grizzie17/Rollator-Vision/README.md

# Rollator-Vision #

Ultrasonic sensors for a Rollator (Walker).  The goal is to provide assistance for visually impared individuals that must use a walker and thus can not use a blind tapper cane.

The first test unit will be married to a `Medline Empower Rollator Walker`.

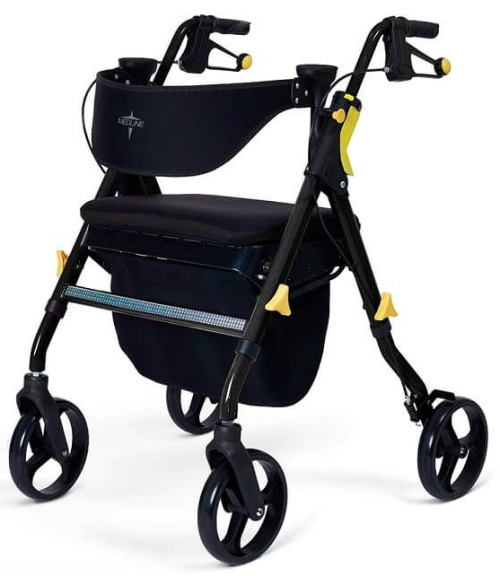
[picture p1: images/medline_empower_rollator_black.jpg]
Medline Empower Rollator Walker
  
Medline Empower Rollator Walker

This first unit will be mounted on the front horizontal bar in front of the storage bag.

| description | dimension |
| --- | --- |
| Overall Width | 26.5 in |
| Cross Bar Width | ~17 in |
| ~ Cross Bar Angle | 60 deg |

-----

## Requirements ##

* Warn user when nearing obstacles.
  * User adjustable distance range.
  * Vibrate handles
  * three different vibration patterns:
    * front, side, both
* Battery powered without the need for on/off switches
  * Battery must last for at least two weeks but preferred four weeks

-----

## Overall Circuit ##

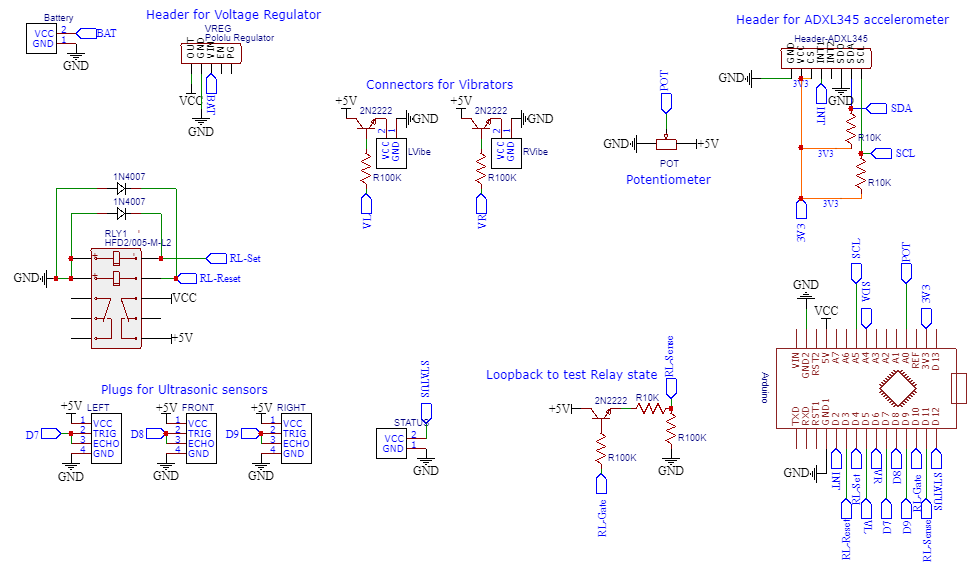
[picture p2: images/rollator-circuit-v6.png]
Circuit


The core of the system is an `Arduino nano` microprocessor.  No devices (sensors) are powered directly from the microprocessor with the exception of the ADXL345 accelerometer (which is powered from the microprocessor's 3.3V pin).

One of the main requirements is that there be no need for a user selectable power switch.  To accomplish this we must be very judicious with the power. We will powerdown or force devices to enter a sleep-mode.  We use an accelerometer to recognize motion (or lack thereof) and wake up or put the microprocessor to sleep as needed.  The microprocessor and the accelerometer are the only items that have continuous power (but both can be put to sleep), all other devices are powered via a 5V relay.  When the microprocessor sleeps the relay disconnects the power.

The microprocessor polls three ultrasonic sensors at an effective rate of 12hz (that is 4hz for each sensor multiplied by the number of sensors).  The three ultrasonic sensors are arranged with one forward facing sensor, and two side facing sensors (left and right).

To provide user feedback, there are two vibrators that will be placed, one in each handle bar.  No vibration indicates that no obstacles are near.  Vibration from both handles indicates that an obstacle is ahead of the Rollator.  An individual handle vibrating indicates obstacles on the corresponding side.

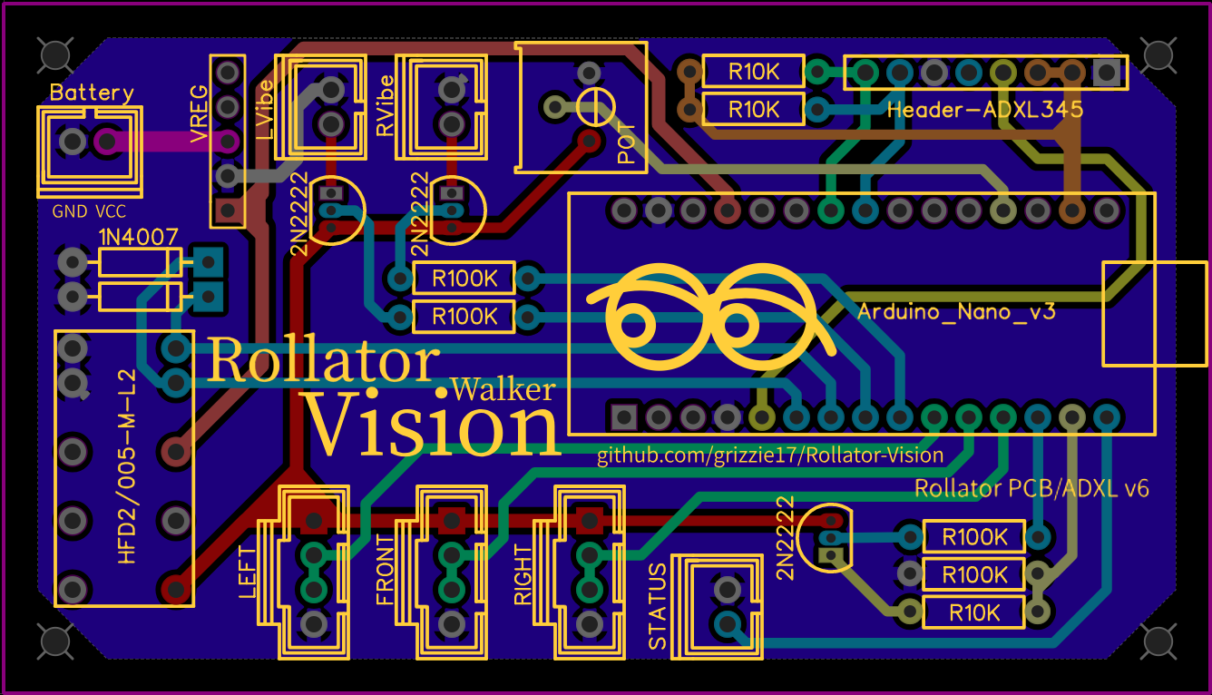
[picture p3: images/PCB-v6.png]
Printed Circuit Board
  
Printed Circuit Board Diagram

-----

## Arduino nano ##

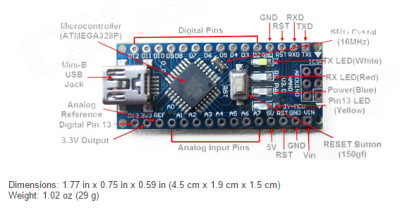
[picture p4: images/arduino-nano-rev3.png]
Arduino Nano V3


The `Arduino Nano V3` microprocessor is the heart of our Rollator-Vision project.

To reduce power, we unsolder the `Power` and `Pin13` LEDs. The other LEDs should be okay since in the non-debug version we don't write anything to the Serial Console (TX,RX);

Please see the tables in the sections below for connection details to the Arduino.

-----

## Battery Pack ##

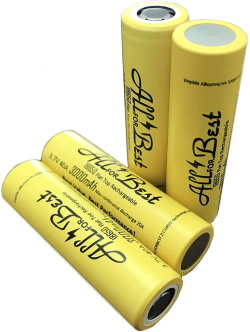
[picture p5: images/18650_3000mAh.jpg]
18650 Batteries


The `Battery Pack` will be made from 18650 batteries.  Each pack is configured as 2S4P (2 Series and 4 Parallel).  Each battery cell is rated at 3000 mAh, providing an overall nominal rating, 7.4V 12000 mAh. The actual voltage range is from 8.30V to 5.80V.  We are also experimenting with a 2S2P battery pack with half the milliamp-hour rating.

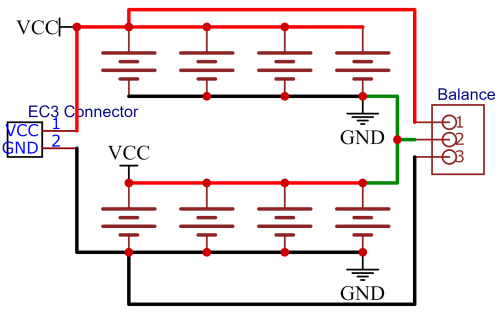
[picture p6: images/battery-pack-circuit.png]
battery-pack-circuit


The packs will use an EC3 connector (frequently used on R/C models), and a 3 wire balance connector which will allow the pack to be charged using a standard R/C balancing battery charger (that includes a Li-Ion setting).

-----

## Voltage Regulator ##

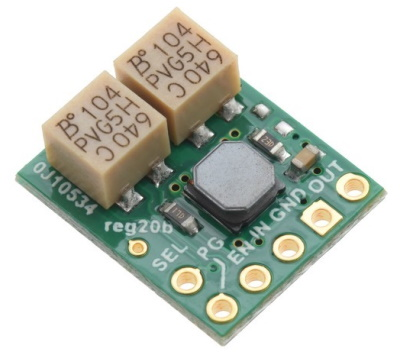
[picture p7: images/pololu-1.jpg]
Pololu Regulator


Pololu 2.5-16V Fine-Adjust Step-Up/Step-Down Voltage Regulator w/ Adjustable Low-Voltage Cutoff S9V11MACMA

[Spec. Sheet](https://www.pololu.com/product/2868)

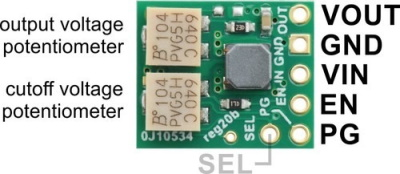
[picture p8: images/pololu-3.jpg]
Regulator Pins


| pin  | description |
| ---- | --- |
| VOUT | Output voltage; determined by the trimmer potentiometer |
| GND  | Ground |
| VIN  | Input voltage; should be between 3V-16V |
| EN | Enable; used for setting cutoff voltage |
| PG | Power Good |

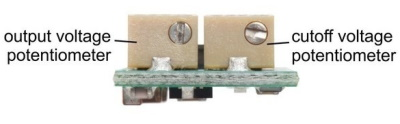
[picture p9: images/pololu-2.jpg]
Setting Output and Cutoff


### Setting the output voltage ###

The output voltage of the regulator is controlled with a 12-turn precision potentiometer. Turning the potentiometer clockwise increases the output voltage, and it can be measured using a multimeter.

> Connect your powersupply (fully charged battery) to the VIN and GND. Connect your multimeter to the GND and VOUT.  Adjust the potentiometer so the VOUT is 5.15V.

### Setting the cutoff voltage ###

The low VIN cutoff voltage of the regulator is controlled by adjusting the voltage at the EN pin with a 12-turn precision potentiometer. When the voltage on the EN pin falls below 0.7V the regulator is put in a low-power sleep state and when the voltage on EN rises back above 0.8V the regulator is turned back on. Turning the potentiometer clockwise increases the low-voltage cutoff. The cutoff voltage can be set by measuring the voltage on the VIN and EN pins and using the potentiometer to adjust the voltage on EN according to the following equation:

EN / 0.7V = VIN / VIN cutoff

EN = VIN * 0.7V / VIN cutoff

For example, if you connect VIN to a battery that currently measures 3.7V and you want to set the cutoff voltage to 3.0V, the equation becomes:

EN / 0.7V = 3.7V / 3.0V

Solving for EN yields approximately 0.86V, so you should turn the potentiometer until you measure that voltage on the EN pin.

Note that the regulator’s low VIN cutoff behavior includes hysteresis: the regulator turns off when EN falls below 0.7V, but it does not turn back on until EN rises above 0.8V. Therefore, VIN must reach about 114% of the cutoff voltage before the regulator will re-enable its output (about 3.43V in this example).

### So for our purposes ###

> Connect your powersupply (battery) to the VIN and GND. Connect your multimeter to GND and EN pins to correctly measure and adjust the cutoff voltage.

LiPo VIN cutoff should be 7.0V and the fully charged battery pack should be 8.4V.

EN = 8.4V * 0.7V / 7.0V  
EN = 0.87

Li-Ion VIN cutoff should be 5.8V and the fully charged battery pack should be 8.3V.

EN = 8.3V * 0.7V / 6.4V  
EN = 0.908

-----

## ADXL345 Accelerometer ##

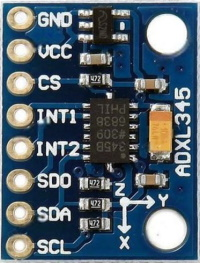
[picture p10: images/ADXL345-Accelerometer-Module.jpg]
ADXL345 Accelerometer


The `Accelerometer` is used for two purposes in our system:

* provide a wakeup/sleep identifier based on motion of the walker.
* recognize that the walker has been layed down on either its back or its side and put the walker to sleep regardless of other motion.

We use the I2C connections using SDA and SCL.

The following table identifies the connections for the
ADXL345 to an Arduino Nano

| ADXL345 | Arduino | Notes |
| --- | --- | --- |
| GND | GND | |
| VCC | 3.3V | |
| CS | 3.3V | |
| INT1 | D2 (INT0) Yellow | use Interrupts |
| INT2 | - | |
| SD0 | GND | |
| SDA | A4 (SDA) blue | 10k resistor to VCC |
| SCL | A5 (SCL) green | 10k resistor to VCC |
| | | |

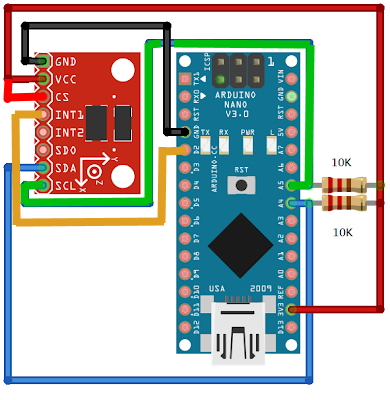
[picture p11: images/adxl345.png]
  
Connection Diagram

-----

## Relay ##

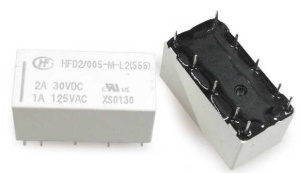
[picture p12: images/HFD2-005-M-L2-D.jpg]
Relay


The relay is used to power-up the ultrasonic sensors and other devices (with the exception of the ADXL345) for when they are needed. Otherwise they are powered-down.

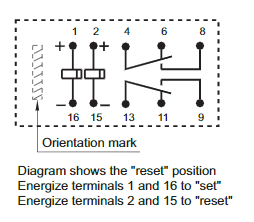
[picture p13: images/Relay-pins.png]
Relay-Pins


> Please note that the pins identified above are not sequential.  They are using position on a breadboard (e.g., pins 3,5,7,10,12,14) are non-existant. In our case, we will not be using pins 6, 9-13.

The relay being used has been changed to the HFD2/005-M-L2-D which is a double poll double throw relay.  The important part of this relay is that it does not require power to maintain set/reset condition.  There are two pins that control the unit; one for `set` (on) and the other for `reset` (off).  Setting the appropriate pin to +5V for 5 milliseconds will change the relay setting.

| Relay | Arduino | Circuit |
| ----- | --- | --- |
| 1 | D3 | (reset) |
| 2 | D4 | (set) |
| 4 | | VCC (from Reg.) |
| 8 | | OUT +5V |
| 16,15 | GND | GND |

-----

## HC-SR04 Ultrasonic Sensors ##

There are three HC-SR04 sensors.  One facing forward,
one facing left, one facing right.

| HC-SR04 | Arduino | Notes |
| --- | --- | --- |
| VCC | - | Relay VOUT |
| Trigger | D7,8,9  | Echo connected |
| Echo | Trigger | |
| GND | GND | |

Using the `YogiSonic` library allows us to connect the `trigger` and `echo` pins so we save pins on the Arduino.

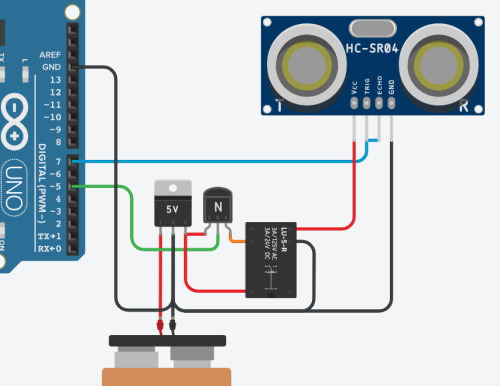
[picture p14: images/HC-SR04.png]


> This diagram is not completely accurate but does represent an external battery being sent through a voltage regulator and then a [relay](#relay).

-----

## Vibrator ##

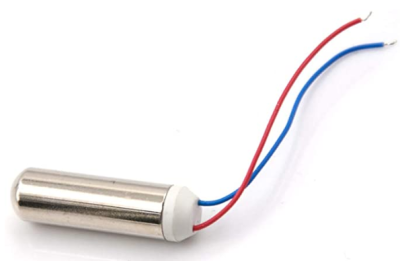
[picture p15: images/vibrator.png]
Vibrator


* Size: 7 x 25 mm
* Voltage: 1.5-3V

Used in Rollator/Walker hand-grips to notify user of obstacles.

We will use RCA jacks to connect the vibrator to the sensor housing (box).

-----

## Parts List ##

| ID | Name | Qty |
| --- | --- | --- |
| Nano | Arduino nano V3 | 1 |
| HC-SR04 | Ultrasonic sensor | 3 |
| ADXL345 | Accelerometer | 1 |
| HFD2-005-M-L2-D | Latching Relay | 1 |
| S9V11MACMA | Pololu 2.5-16V Regulator | 1 |
| X0023QDG3D | Vibrator | 2 |
| LED | Status LED | 1 |
| 7.4V 12,000mAh  | 18650 (8) Battery Pack | 2+  |
| | | |
| 100K | Resistor | 2 |
| 10K | Resistor | 2 |
| 660 | Resistor | 2 |
| 2N2222 | Transistor | 3 |
| 1N4007 | Diode | 2 |

## Connectors ##

| Name | Usage | Qty |
| --- | --- | --- |
| 2pin Header  | Battery, Left/Right vibe, LED | 4 |
| 5pin Header  | Voltage regulator | 1 |
| 4pin Header  | Left/Front/Right Ultrasonic | 3 |
| 8pin Header  | ADXL345 | 1 |
| 15pin Header | Arduino nano | 2 |
| | | |
| EC3 Female | PCB to battery | 1 |
| EC3 Male | battery pack | 2 |
| 3pin balance | battery pack | 2 |
| | | |
| RCA Female | connector to PCB | 2 |
| RCA Male | lead to vibrator | 2 |

## Wiring Harnesses ##

### Battery Pack (2) ###

Two wiring harnesses per battery pack:

* EC3 Female connector, 16awg (red and black) wire (about 5"), soldered directly to pack.

* 3pin balance lead, soldered directly to three connections.

### Battery Connector ###

* EC3 Male connector, 16awg (red and black) wire, 2pin male Dupont connector

### Vibrator (2) ###

Two wiring harnesses:

* 2pin male Dupont connector, 22awg wire, RCA Female connector.  RCA Female connectors will be mounted in top of the sensor box (one left and one right).

* RCA Male connector with attached wiring directly soldered to the vibrators (one left and one right).

### Ultrasonic Sensors (3) ###

* 4pin male Dupont connector, 4-wire ribbon cable, 4pin female Dupont connector

-----

# Assembly #

* Solder potentiometer
* Solder relay
* Solder in resistors
* Solder headers for:
  * battery
  * voltage regulator
  * Arduino nano
  * left/right vibrators
  * Ultrasonic sensors
  * LED
  * accelerometer
* Solder two NPN BJTs (2N2222)

* Create wiring harnesses: (provide some slack but not too much). All wiring harnesses will use ribbon cables with Dupont connectors.
  * battery - 2 wire - with EC3 connector on the battery side
  * left/right vibrators - 2 wire - male connectors to female RCA jacks - vibrator to male RCA jacks
  * LED - 2 wire
  * left/front/right ultrasonic sensors - four wire - male on one side and female on the other
  * ADXL345? - 8 wire

-----

# Power #

This section contains measured information for the power usage and batteries.

| mA | Notes |
| ----: | --- |
| 120.2 | Batteries to Buck (Active) |
|  19.2 | Batteries to Buck (Sleep)  |
| 3.6 | Buck to Main |
|  15.6 | Buck load |
| | |
|  87.0 | Battery to Pololu (Active) |
| 2.5 | Battery to Pololu (Sleep)  |
| 3.6 | Pololu to Main ????? |

Question: Why is the "Pololu to Main" more than the "Battery to Pololu"?

## Endurance Test w/ LiPo Pack ##

LiPo battery 2S 7.4V (nominal) 5200 mAh 35C

| mA |  Day | Date |
| ---- | ---: | ---- |
| 8.39 | 1 | 7/28 |
| 8.14 | 7 | 8/3  |
| | | |
| 8.09 | 8 | 8/4  |
| 7.97 | 12 | 8/8  |

At the finishing voltage and the discharge rate we would most likely get close to three weeks of usage on a single charge.

## Endurance Test w/ 18650 2S4P Battery Pack ##

Li-Ion battery pack 2S4P 7.4V (Nominal) 12000 mAh

| mA |  Day | Date |
| ---- | ---: | ---- |
| 8.30 | 1 | 8/8  |
| 8.18 | 7 | 8/14 |
| | | |
| 8.16 | 8 | 8/15 |
| 8.13 | 14 | 8/21 |
| | | |
| 8.13 | 15 | 8/22 |
| 8.04 | 21 | 8/28 |
| | | |
| 8.03 | 22 | 8/29 |
| ?.?? | 23 | 8/30 |

Our goal with the Li-Ion pack is to get around four weeks of usage on a single charge.  At the current discharge rate we would most likely get five or more weeks of usage on a single charge.

## Endurance Test w/ 18650 2S2P Battery Pack ##

Li-Ion battery pack 2S2P 7.4V (Nominal) 6000 mAh.

The desire with the 2S2P is to be lighter and the housing can be made smaller for standard walkers.

| mA |  Day | Date |
| ---- | ---: | ---- |
| 8.26 | 0 | 9/11 |
| 8.24 | 1 | 9/11 |
| 8.21 | 2 | 9/12 |
| 8.19 | 3 | 9/13 |
| 8.17 | 4 | 9/14 |
| 8.16 | 5 | 9/15 |
| 8.15 | 6 | 9/16 |
| 8.13 | 7 | 9/17 |
| | | |
| 8.?? | 8 | 9/18 |
| 8.10 | 9 | 9/19 |
| ? | 10 | 9/20 |
| ? | 11 | 9/21 |
| ? | 12 | 9/22 |
| ? | 13 | 9/23 |
| ? | 14 | 9/24 |
| ? | | |
| 7.91 | 15 | 9/25 |
| 7.88 | 16 | 9/26 |
| 7.86 | 17 | 9/27 |
| 7.?? | 18 | 9/28 |
| 7.81 | 19 | 9/29 |
| 7.79 | 20 | 9/30 |
| 7.76 | 21 | 10/1 |
| | | |
| 7.?? | 22 | 10/2 |
| 7.64 | 23 | 10/3 |
| 7.46 | 24 | 10/4 |

Theroetically, this battery pack should achieve half of the 2S4P battery pack.  Three weeks might be possible.

## Battery Voltage Ranges ##

| Type | Nominal | Max  | Min |
| --- | --- | ---- | --- |
| 2S LiPo | 7.4 | 8.40 | 7.0 |
| 2S Li-Ion | 7.4 | 8.30 | 5.8 |
