grizzie17/Rollator-Vision/EasyEDA/Schematic_Rollator_2020-10-01_15-58-42.png

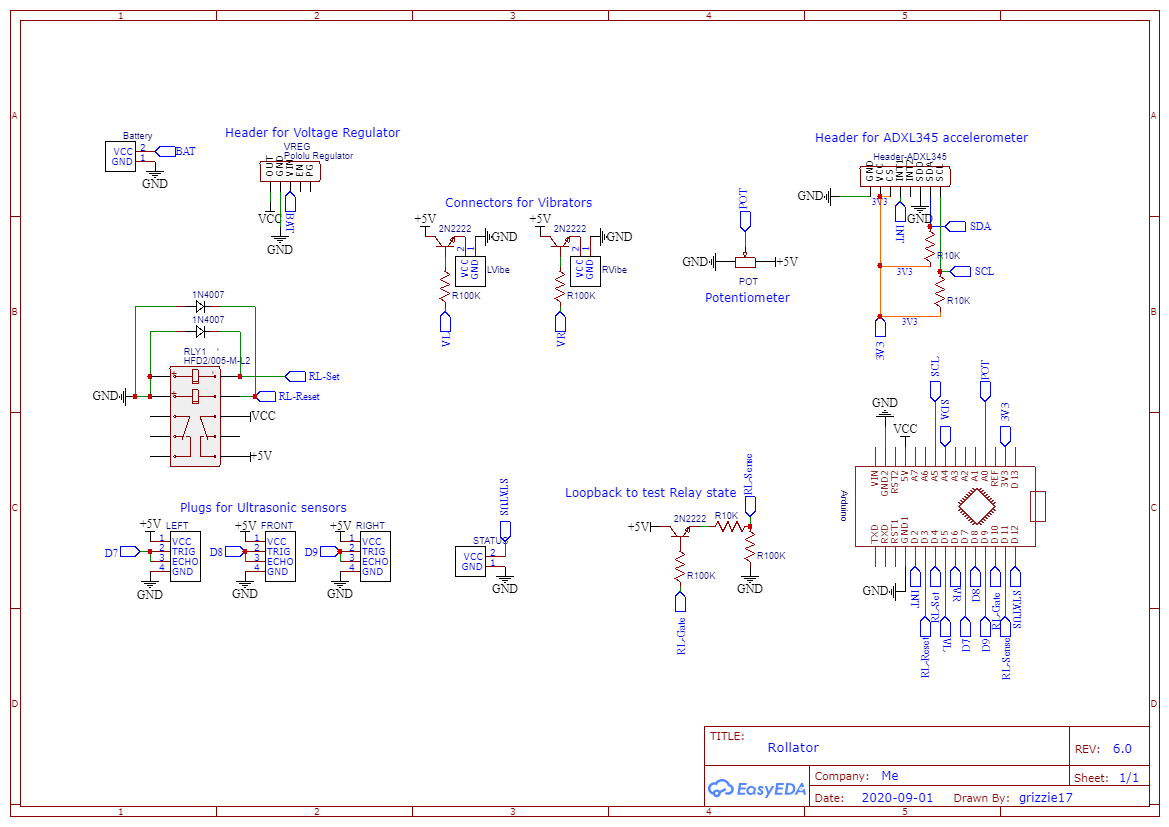
EasyEDA/Schematic_Rollator_2020-10-01_15-58-42.png
