grizzie17/Rollator-Vision/images/Arduino-nano.jpg

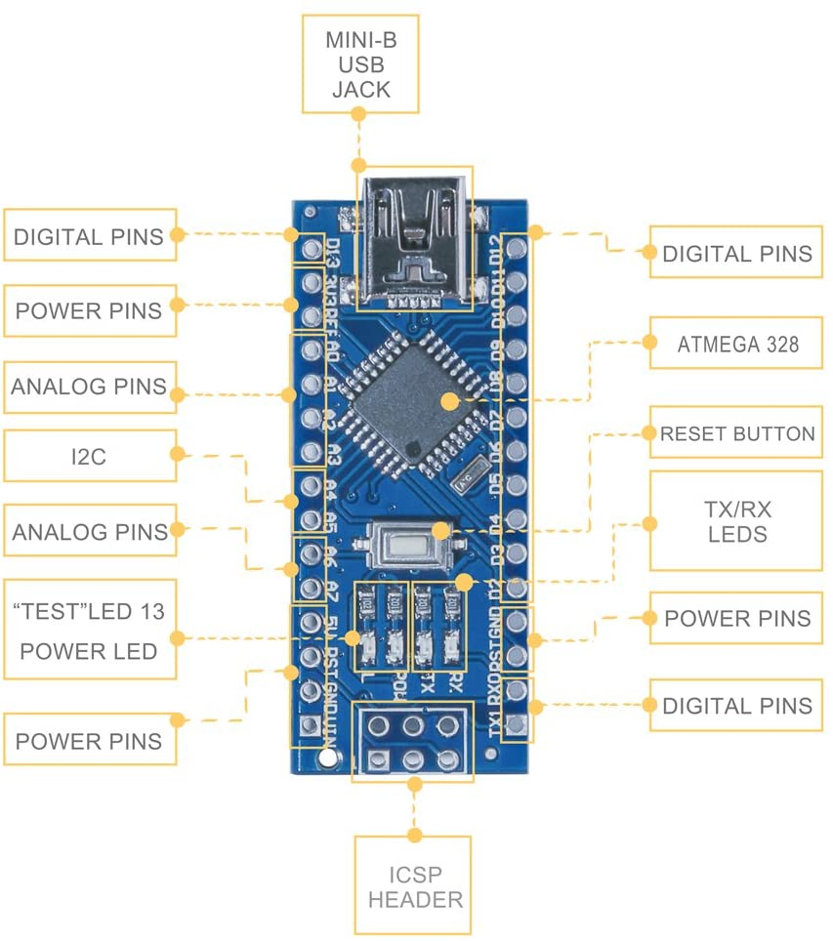
images/Arduino-nano.jpg
