grizzie17/Rollator-Vision/images/Arduino-Relay.jpg

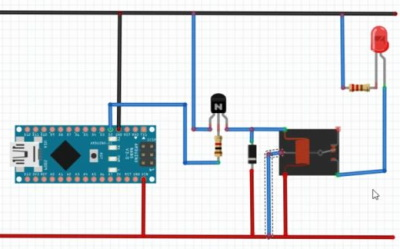
images/Arduino-Relay.jpg
