grizzie17/Rollator-Vision/images/PCB-L.png

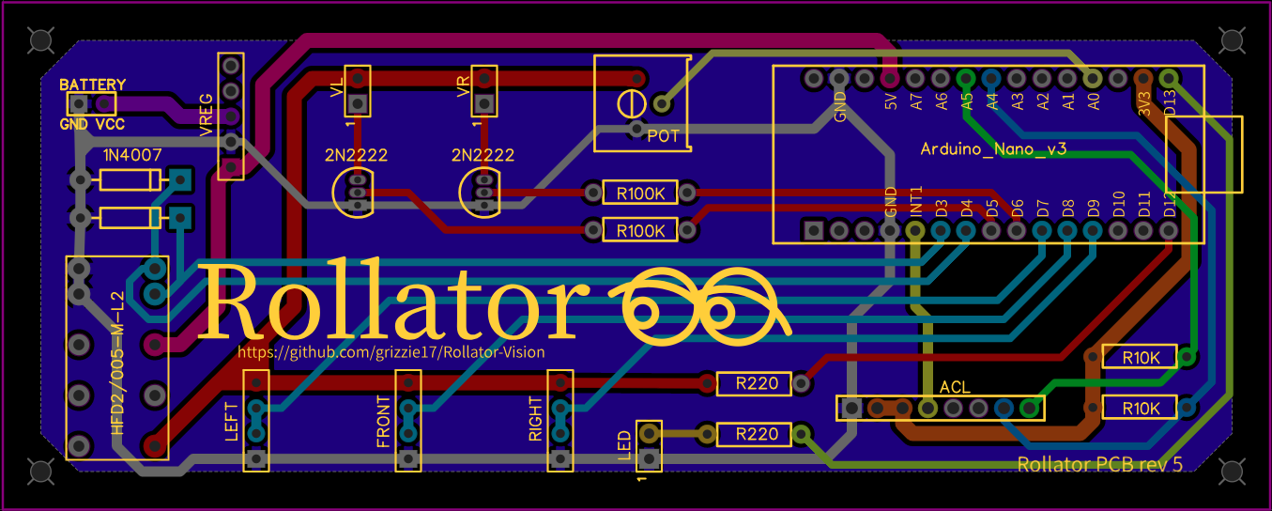
images/PCB-L.png
