grizzie17/Rollator-Vision/images/PCB-silkscreen.png

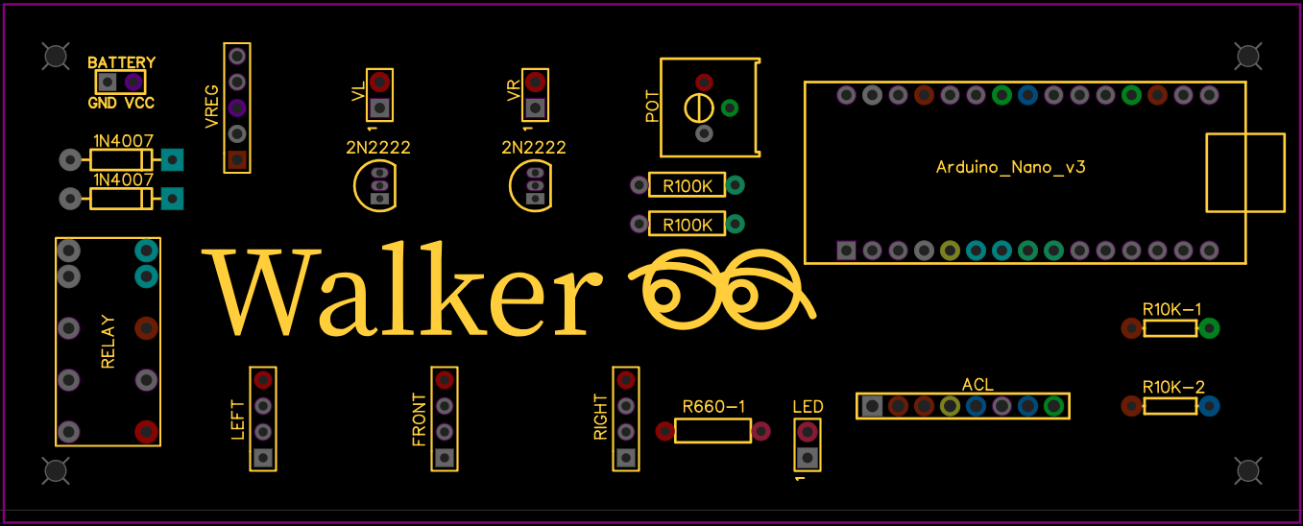
images/PCB-silkscreen.png
