grizzie17/Rollator-Vision/images/relay.jpg

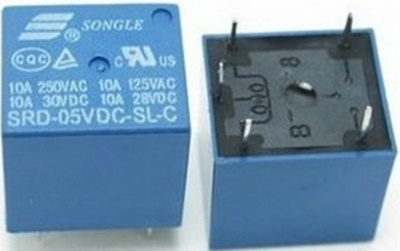
images/relay.jpg
