grizzie17/Rollator-Vision/images/rollator-circuit-breadboard.png

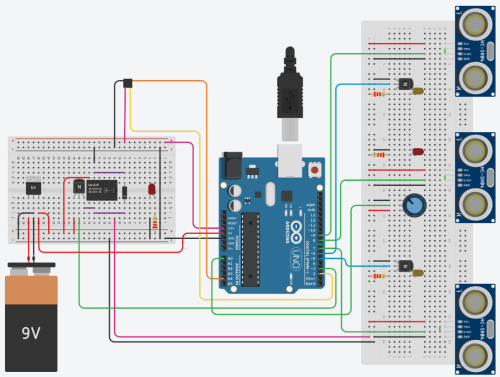
images/rollator-circuit-breadboard.png
