grizzie17/Rollator-Vision/images/rollator-circuit.png

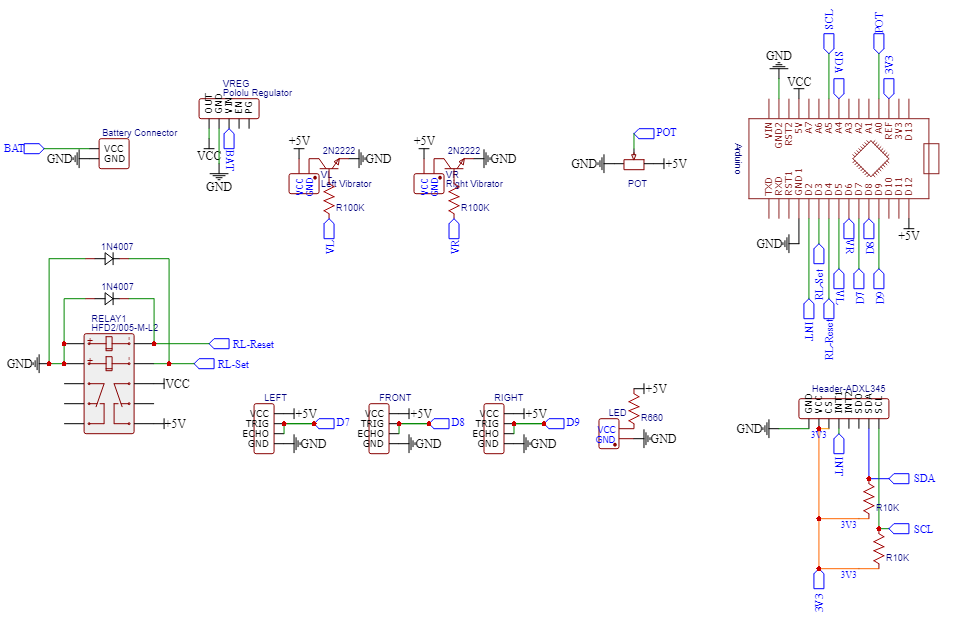
images/rollator-circuit.png
