grizzie17/Rollator-Vision/images/SRD-05VDC-SL-C-circuit.png

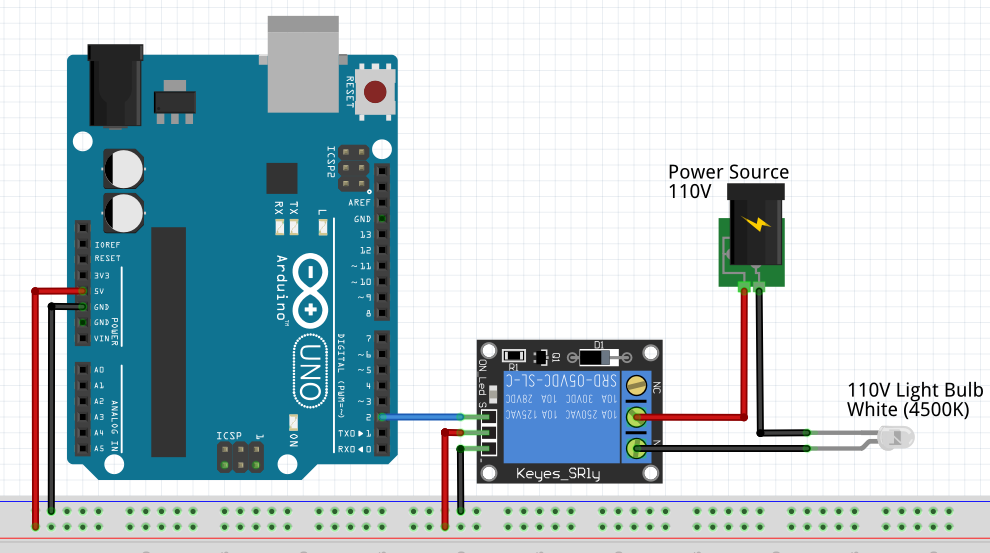
images/SRD-05VDC-SL-C-circuit.png
