grizzie17/Rollator-Vision/images/SRD-05VDC-SL-C.png

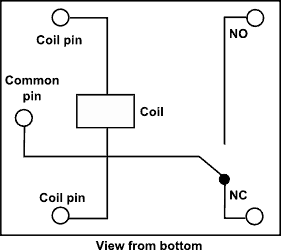
images/SRD-05VDC-SL-C.png
