grizzie17/Rollator-Vision/(list of files, drawings)

Other design files:
EasyEDA/Rollator_2020-08-26_12-51-18.json
