grizzie17/Rollator-Vision/(commit log)

2020-06-22 add pinout and wiring pictures
2020-06-22 Add sensors
    * now provides four ultra sonic sensors
    * reserve pins for left/right vibrators (currently using LEDs)
    * add accelerator
    * potentiometer to adjust notification distance
    [rollator-sensors.ino]
2020-06-25 New picture of Relay circuit
2020-06-25 lots of tweaks to get the Accelerometer working
2020-07-23 Add wiring information to README.md
2020-07-23 New diagram for ADXL345 wiring
2020-07-23 significant rework
    Near complete rewrite
    [rollator-sensors.ino]
2020-07-29 Power usage information
2020-07-31 Timed test results & battery ranges
2020-07-31 Attempted fix for Buzzer
    When the Vibrator is buzzing it may interfere with the motion detection
    [rollator-sensors.ino]
2020-08-02 New picture of Sonic Sensor circuit
2020-08-05 Updates
    * new picture of Rollator
    * add dimensions of Rollator
    * adjust details for ultrasonic sensors
    * Pololu shutoff calculation for EN pin
2020-08-08 Update information on 18650 battery pack
2020-08-09 Update Battery endurance test
2020-08-11 New descriptions for the Relay component
2020-08-11 PCB data
    [PCB_2020-08-11_09-28-56.json, Rollator_2020-08-11_09-29-25.json]
2020-08-11 New Relay datasheet
2020-08-11 Add image of PCB to README
2020-08-18 PCB gerber files
    [PCB_2020-08-11_09-28-56.json, Rollator_2020-08-11_09-29-25.json]
2020-08-20 Updated to represent power coming from external source
2020-08-20 updated to reflect current design
2020-08-20 change to release
    Also recognize when potentiometer is not being powered.
2020-08-21 Add more content to readme
    * Add battery pack circuit
    * Assembly instructions
2020-08-21 Fix battery pack diagram
2020-08-23 tweaks to documentation
    * Correct the current approaches
    * Update the endurance-tests
2020-08-23 Update Circuit diagram in README
2020-08-23 updated schematic images in the README
2020-08-23 corrections based on current design
2020-08-24 update schematic
2020-08-26 Update schematics
2020-08-26 Updated the minimum voltage for 18650 cells
2020-08-26 Update README
    * Change project name to Rollator-Vision
    * Update PCB graphics to also reflect Rollator-Vision
2020-08-27 Gerber and EasyEDA files
    [Rollator_2020-08-26_12-51-18.json]
2020-08-27 adjust parts list, and add wiring-harness description
2020-09-07 update circuit PCB diagrams and assorted changes
2020-10-04 PCB board files
2020-10-04 schematics for PCB v6
2020-10-26 revisions for PCB6
2020-11-08 Identify LEDs that we unsolder
2020-11-08 test vibrator pins for new board
    [buzzer.ino]
2020-11-08 test relay for new PCB board
2020-11-08 add the 'status' LED support
2020-11-08 Tweak usage of statusLED
    Originally tried to use as a variable intensity LED.
    Realized that PWM pin was required.
2020-11-27 adjust low-voltage of Li-Ion batteries
